FeruMaga/SistemasEmbarcados2DataLogger/Circuitos/circuito SD.jpg

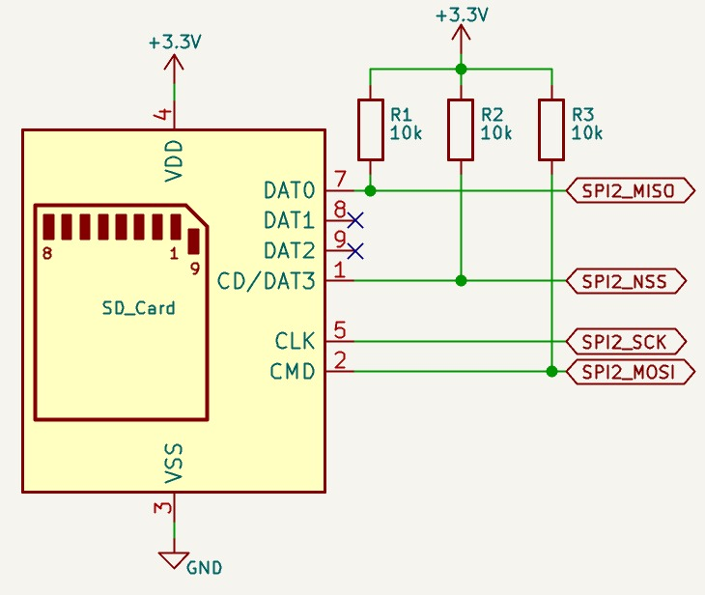
Circuitos/circuito SD.jpg
