FeruMaga/SistemasEmbarcados2DataLogger/Circuitos/circuito Temperatura.jpg

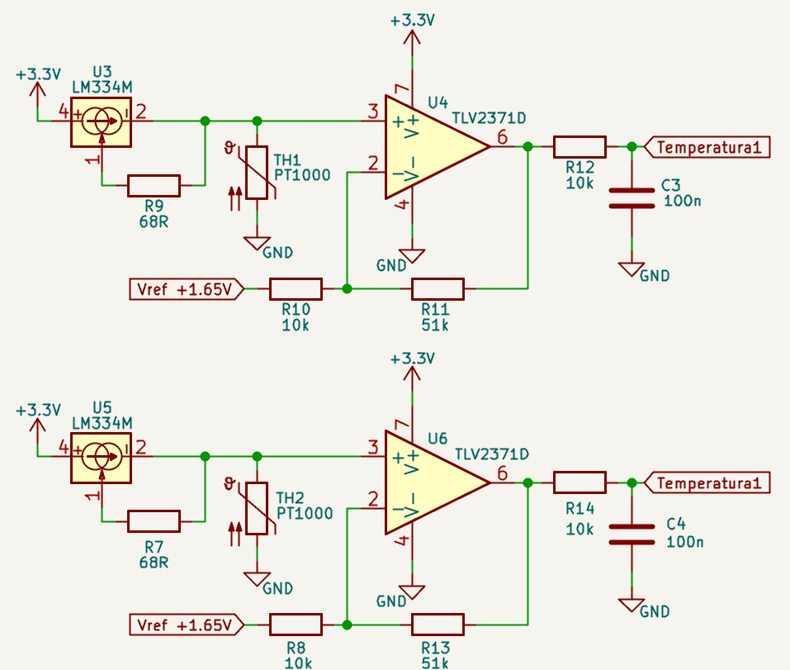
Circuitos/circuito Temperatura.jpg
