FeruMaga/SistemasEmbarcados2DataLogger/Circuitos/circuito.jpg

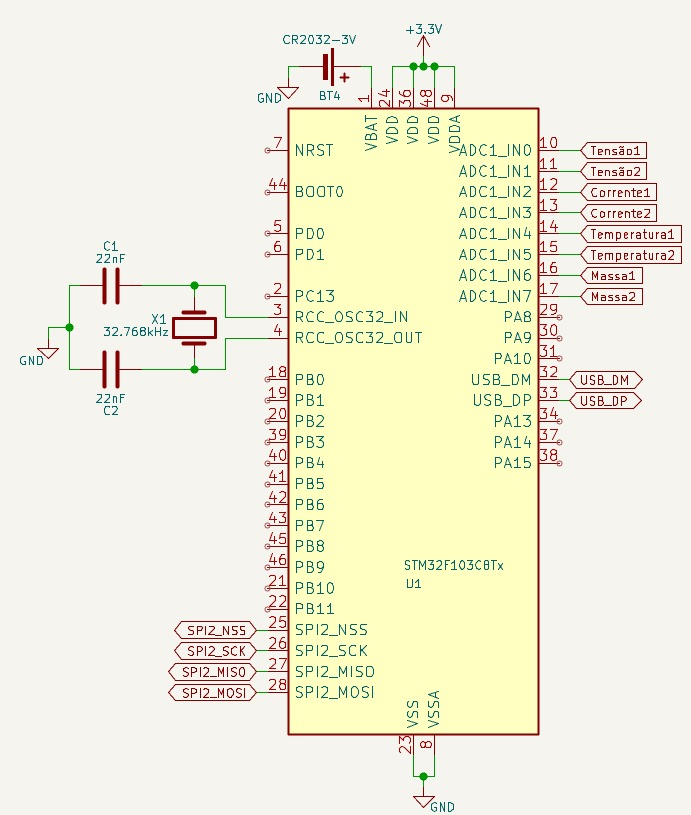
Circuitos/circuito.jpg
