FeruMaga/SistemasEmbarcados2DataLogger/projeto-embarcados/Core/Src/main.c

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
/* Includes ------------------------------------------------------------------*/
#include "main.h"
#include "fatfs.h"
#include "usb_device.h"

/* USER CODE BEGIN Includes */
#include "adc_sensor.h"
#include "filter.h"
#include "rtc_utils.h"
#include "sd_logger.h"
#include "usb_comm.h"
#include <stdio.h>
#include <string.h>
/* USER CODE END Includes */

ADC_HandleTypeDef hadc1;
DMA_HandleTypeDef hdma_adc1;

I2C_HandleTypeDef hi2c1;

RTC_HandleTypeDef hrtc;

SPI_HandleTypeDef hspi2;

DMA_HandleTypeDef hdma_memtomem_dma1_channel2;
void SystemClock_Config(void);
static void MX_GPIO_Init(void);
static void MX_DMA_Init(void);
static void MX_ADC1_Init(void);
static void MX_I2C1_Init(void);
static void MX_SPI2_Init(void);
static void MX_RTC_Init(void);
/* USER CODE BEGIN 0 */
char logBuffer[256];
char timestamp[32];
uint32_t lastLogTime = 0;
const uint32_t LOG_INTERVAL_MS = 1000;

void HAL_ADC_ConvCpltCallback(ADC_HandleTypeDef* hadc)
{
  if (hadc->Instance == ADC1)
  {
    ADC_Sensor_HandleDMA_Complete();
}
/* USER CODE END 0 */

/**
  * @brief  The application entry point.
  * @retval int
  */
int main(void)
{

  /* MCU Configuration--------------------------------------------------------*/

  /* Reset of all peripherals, Initializes the Flash interface and the Systick. */
  HAL_Init();

  /* Configure the system clock */
  SystemClock_Config();

  /* Initialize all configured peripherals */
  MX_GPIO_Init();
  MX_DMA_Init();
  MX_ADC1_Init();
  MX_I2C1_Init();
  MX_SPI2_Init();
  MX_RTC_Init();
  MX_FATFS_Init();
  MX_USB_DEVICE_Init();
  /* USER CODE BEGIN 2 */
  ADC_Sensor_Init(&hadc1);
	SD_Logger_Init(&hspi2);
	USB_Init(&hpcd_USB_FS);
	ADC_Sensor_StartConversion();
  /* USER CODE END 2 */

  /* Infinite loop */
  /* USER CODE BEGIN WHILE */
	 while (1) // Loop infinito: o código dentro deste bloco será executado repetidamente
	  {
    /* USER CODE END WHILE */

    /* USER CODE BEGIN 3 */
		 // Marcadores de código gerados automaticamente para áreas de usuário
		 uint32_t now = HAL_GetTick(); // Obtém o tempo atual em milissegundos desde o boot do microcontrolador

		    // Verifica se o intervalo de tempo para log de dados foi atingido
		    if (now - lastLogTime >= LOG_INTERVAL_MS) {
		        lastLogTime = now; // Atualiza a variável 'lastLogTime' com o tempo atual para a próxima checagem

		        RTC_TimeTypeDef time; // Estrutura para armazenar a hora do RTC
		        RTC_DateTypeDef date; // Estrutura para armazenar a data do RTC
		        RTC_GetDateTime(&hrtc, &time, &date); // Obtém a hora e a data atuais do módulo RTC
		        RTC_FormatDateTime(&time, &date, timestamp, sizeof(timestamp)); // Formata a hora e a data em uma string

		        // Formata os dados do sensor e o carimbo de tempo em uma única string para o log
		        snprintf(logBuffer, sizeof(logBuffer),
		                 "%s;T1=%.2fV;C1=%.2fA;TEMP1=%.2fC;MASSA1=%.2fkg;T2=%.2fV;C2=%.2fA;TEMP2=%.2fC;MASSA2=%.2fkg\r\n",
		                 timestamp,
		                 ADC_Sensor_GetTensao1(),
		                 ADC_Sensor_GetCorrente1(),
		                 ADC_Sensor_GetTemperatura1(),
		                 ADC_Sensor_GetMassa1(),
		                 ADC_Sensor_GetTensao2(),
		                 ADC_Sensor_GetCorrente2(),
		                 ADC_Sensor_GetTemperatura2(),
		                 ADC_Sensor_GetMassa2());

		        SD_Status_t sd_write_status; // Variável para armazenar o status da escrita no SD

		        // Verifica a flag global 'g_sd_card_full' ANTES de tentar escrever.
		        // Se o cartão já foi marcado como cheio/com problema, evitamos a chamada da função de escrita.
		        if (!g_sd_card_full) {
		            sd_write_status = SD_Logger_WriteData(logBuffer); // Tenta escrever a string de log no cartão SD
		        }
		  }
	  }
  /* USER CODE END 3 */
}

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
