FeruMaga/SistemasEmbarcados2DataLogger/projeto-embarcados/Core/Inc/adc_sensor.h

/*
 * adc_sensors.h
 *
 *  Created on: Jun 12, 2025
 *      Author: FeruMaga
 */

#ifndef INC_ADC_SENSOR_H_
#define INC_ADC_SENSOR_H_


#include "main.h"
#include <stdbool.h>


// Definição do número total de canais do ADC.
#define NUM_ADC_CHANNELS 8

// Definições de macros para mapear um nome significativo a cada canal do ADC.
#define ADC_TENSAO1       0
#define ADC_TENSAO2       1
#define ADC_CORRENTE1     2
#define ADC_CORRENTE2     3
#define ADC_TEMPERATURA1  4
#define ADC_TEMPERATURA2  5
#define ADC_MASSA1        6
#define ADC_MASSA2        7

// Definição do valor máximo que o ADC de 12 bits pode retornar.
// Um ADC de 12 bits tem 2^12 = 4096 possíveis valores (de 0 a 4095).
#define ADC_MAX_VALUE 4095.0f

// Definição da tensão de referência analógica usada pelo ADC para a conversão.
#define ADC_VREF_ANALOG 3.3f

// Definição de uma estrutura (struct) para armazenar dados de calibração para cada sensor.
typedef struct {
    float tensao1_offset;
    float tensao1_coeff;
    float tensao2_offset;
    float tensao2_coeff;
    float corrente1_offset;
    float corrente1_coeff;
    float corrente2_offset;
    float corrente2_coeff;
    float temperatura1_offset;
    float temperatura1_coeff;
    float temperatura2_offset;
    float temperatura2_coeff;
    float massa1_offset;
    float massa1_coeff;
    float massa2_offset;
    float massa2_coeff;
    bool isCalibrated;
} CalibrationData_t;

// Declaração de uma variável global de dados de calibração.
extern CalibrationData_t gCalibrationData;

// Funções de Inicialização e Controle do ADC
void ADC_Sensor_Init(ADC_HandleTypeDef* hadc);

void ADC_Sensor_StartConversion(void);
void ADC_Sensor_HandleDMA_Complete(void);

float ADC_Sensor_Convert_Tensao(uint16_t adc_raw, float offset, float coeff);
float ADC_Sensor_Convert_Corrente(uint16_t adc_raw, float offset, float coeff);
float ADC_Sensor_Convert_Temperatura(uint16_t adc_raw, float offset, float coeff);
float ADC_Sensor_Convert_Massa(uint16_t adc_raw, float offset, float coeff);


float ADC_Sensor_GetTensao1(void);
float ADC_Sensor_GetTensao2(void);
float ADC_Sensor_GetCorrente1(void);
float ADC_Sensor_GetCorrente2(void);
float ADC_Sensor_GetTemperatura1(void);
float ADC_Sensor_GetTemperatura2(void);
float ADC_Sensor_GetMassa1(void);
float ADC_Sensor_GetMassa2(void);
#endif /* INC_ADC_SENSOR_H_ */
