FeruMaga/SistemasEmbarcados2DataLogger/(commit log)

2025-06-12 Modificando filter.h apenas
2025-06-13 Atualizando README.md para entrega
